Dilapsky/Position_feedback_system_and_method_based_on_FDM_formula_3D_printers/SJTU Final Defense of university students' Innovative Practice Program(English).pdf

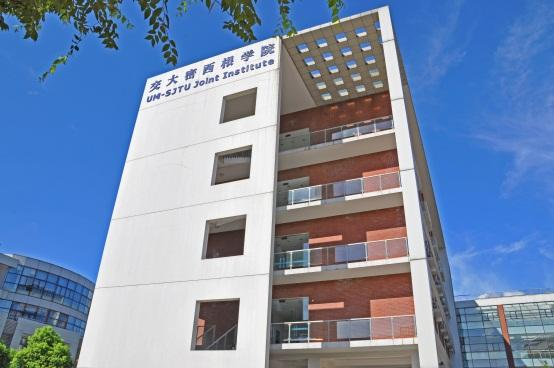
[picture p23: figure]

http://umji.sjtu.edu.cn

Presented by:
李夏涵Li Xiahan
李纯超Li Chunchao

The research about introducing the closed-loop control and blackout continuing printing functions into 3D printers

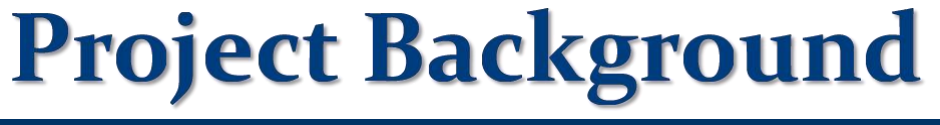
[picture p24: figure]

交大密西根学院 UM-SJTU Joint Institute n Base on the open-loop controlled 3D Printers. n Introduce the closed-loop controlled system

into them by adding the position feedback system whose main part is encoder. n Introduce the blackout continuing printing

system based on previous data. n Thus enhance the accuracy and stability of

3D Printers.

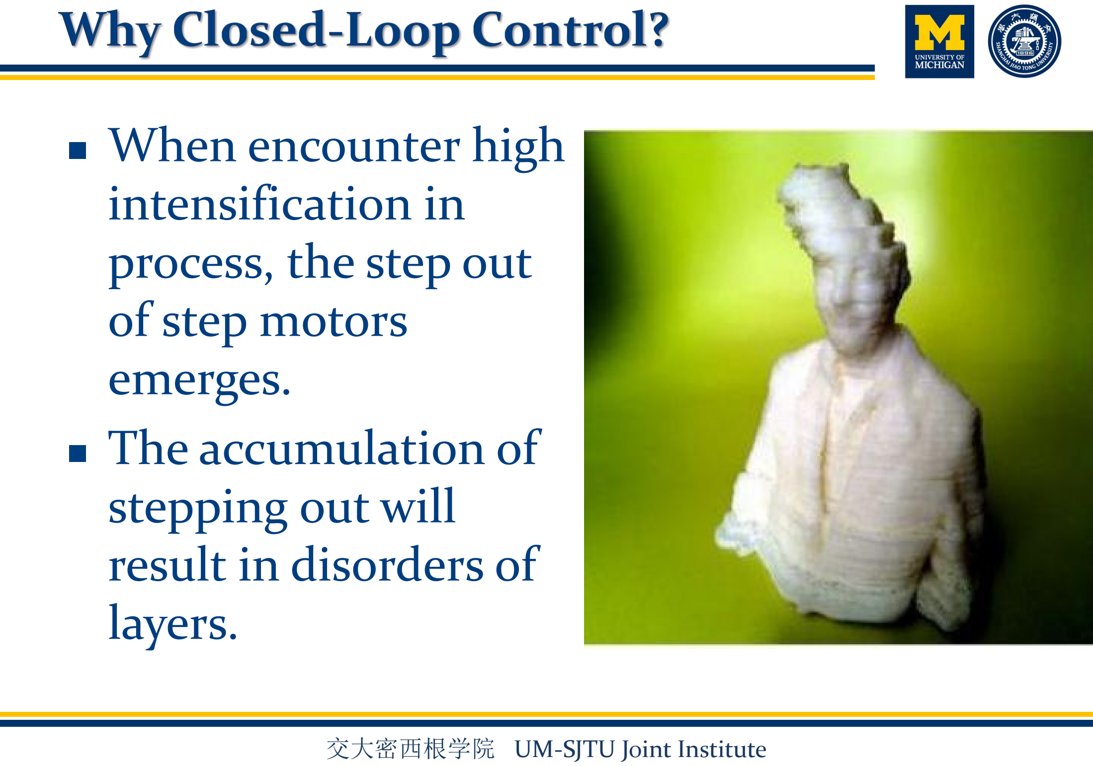
[picture p25: page 3]

n When encounter high
intensification in
process, the step out
of step motors
emerges. n The accumulation of

stepping out will
result in disorders of
layers.

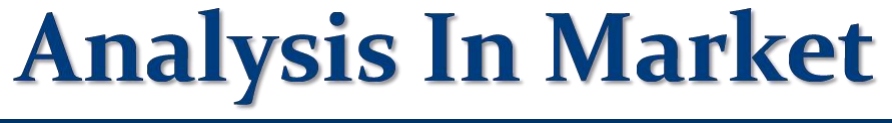
[picture p26: figure]
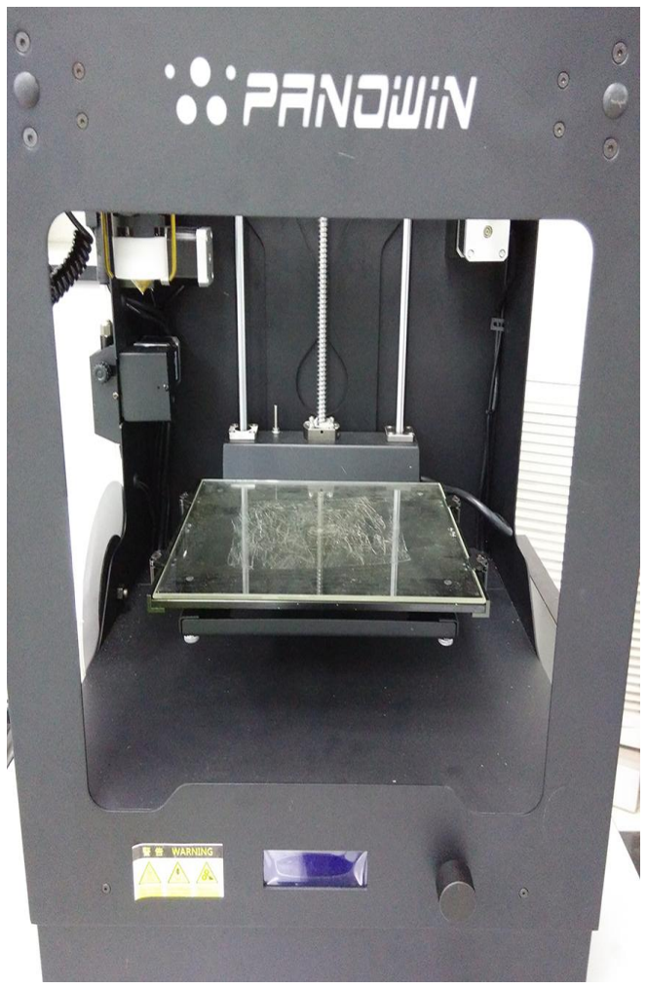
[picture p27: figure]

n Quasi-Industrial 3D prints Closed-Loop Control
Expensive
n Ordinary 3D printers
Open-Loop Control
Affordable
Low-Precision

n 1. Selection of the type of 3D printers n 2. Selection of the type of Encoders n 3. Realization of data transfer
n 4. Realization of close-loop control
n 5. Selection of the module of blackout continuing printing function. n 6. Blackout continuing printing realization

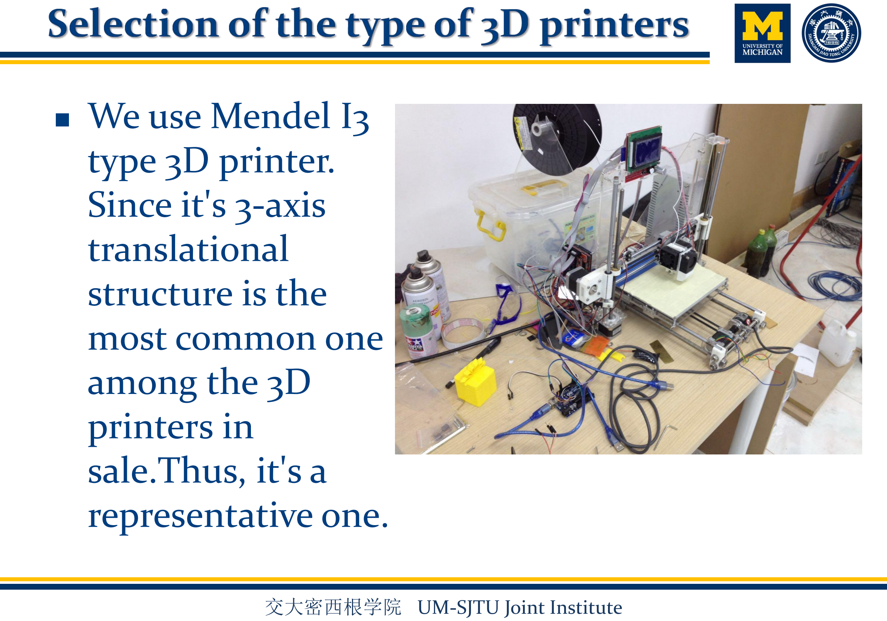
[picture p28: page 6]

n We use Mendel I3
type 3D printer. Since it'
s 3-axis
translational
structure is the
most common one
among the 3D
printers in
sale.Thus, it'

s a
representative one.

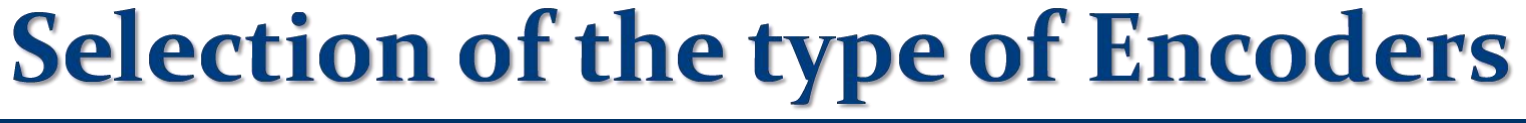
[picture p29: figure]

Price(in RMB) | Additive Type 200 | Absolute Type Above 1000
Advantage | Affordable Easy to Manipulate Low Environment-Affection | Easily Conditioning More Precise
Disadvantage | Difficultly Conditioning Less Precise | Expensive High Environment- Affection

Conclusion: The resolution of x and y axis can reach to 3200, however, the 2000- resolution encoders can recognize the 4000-resolution displacement. Considering about the price and the environment, we will use 2000-resolution encoders

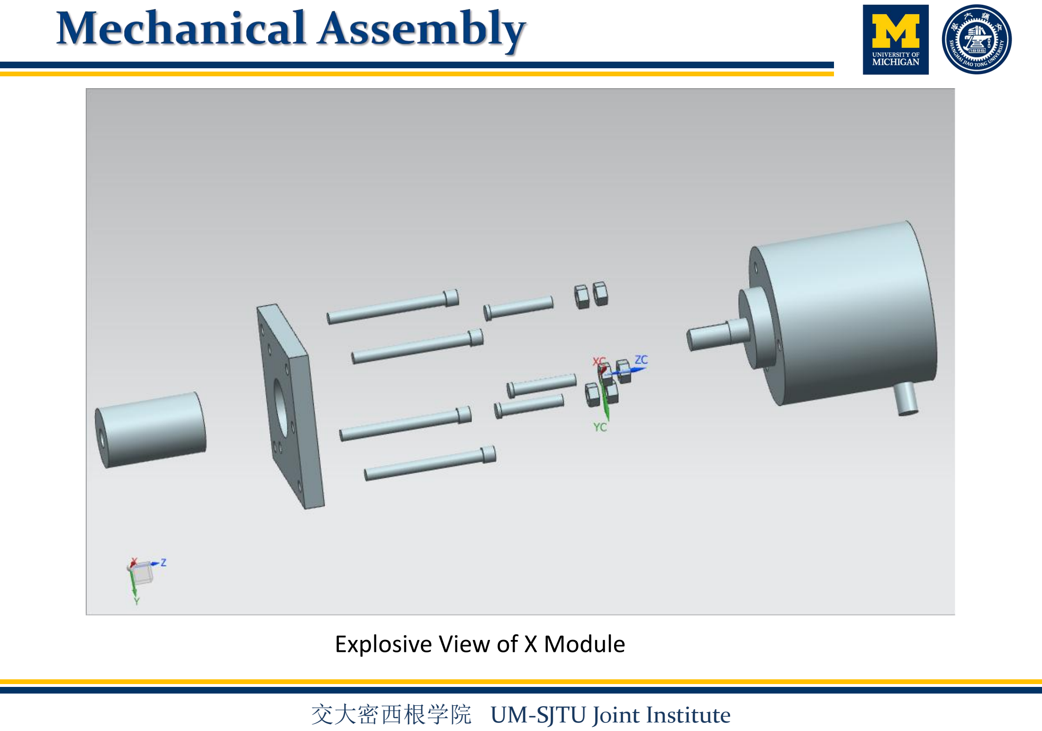
[picture p30: page 8]

Explosive View of X Module

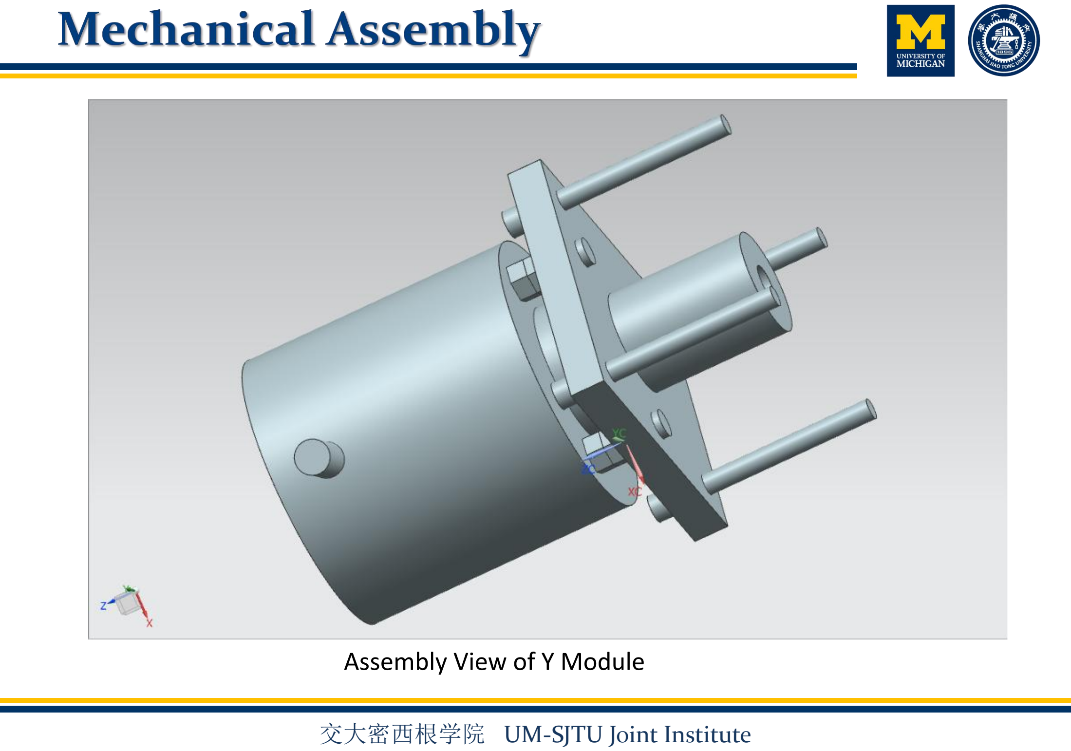
[picture p31: page 9]

Assembly View of Y Module

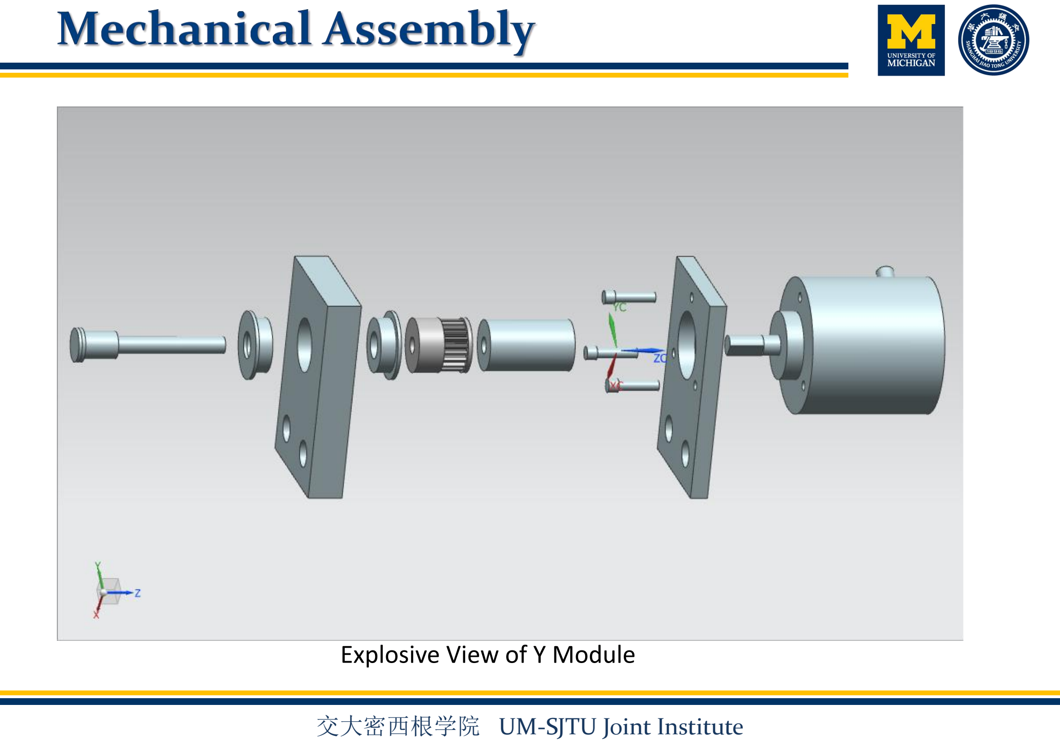
[picture p32: page 10]

Explosive View of Y Module

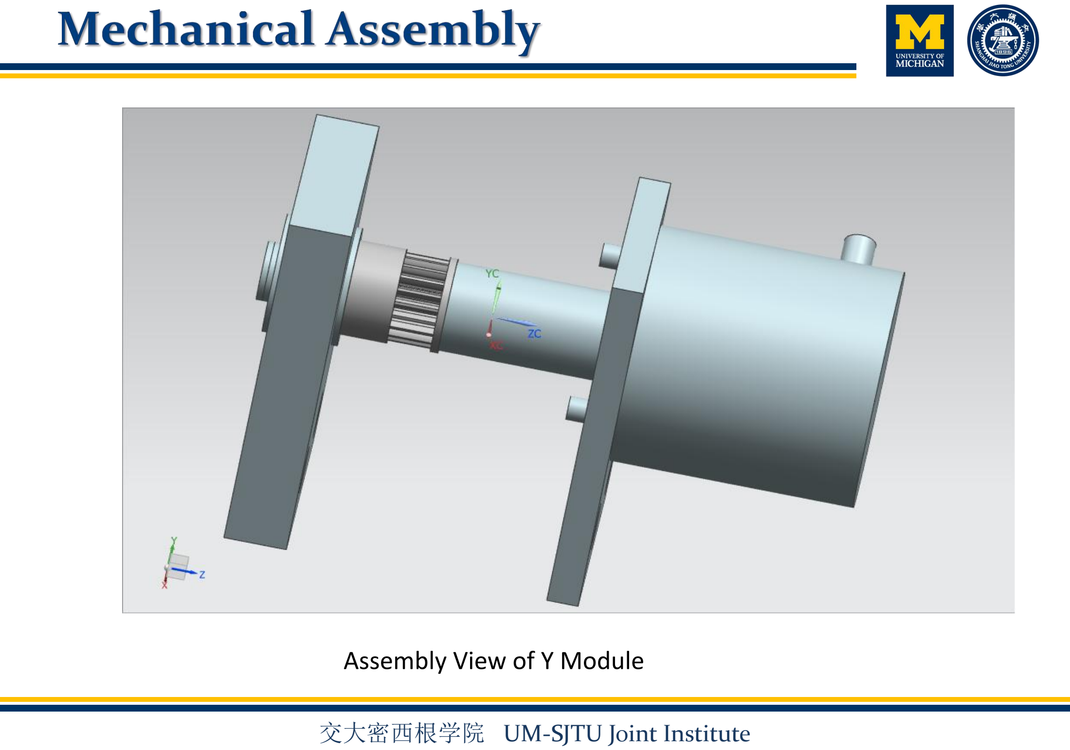
[picture p33: page 11]

Assembly View of Y Module

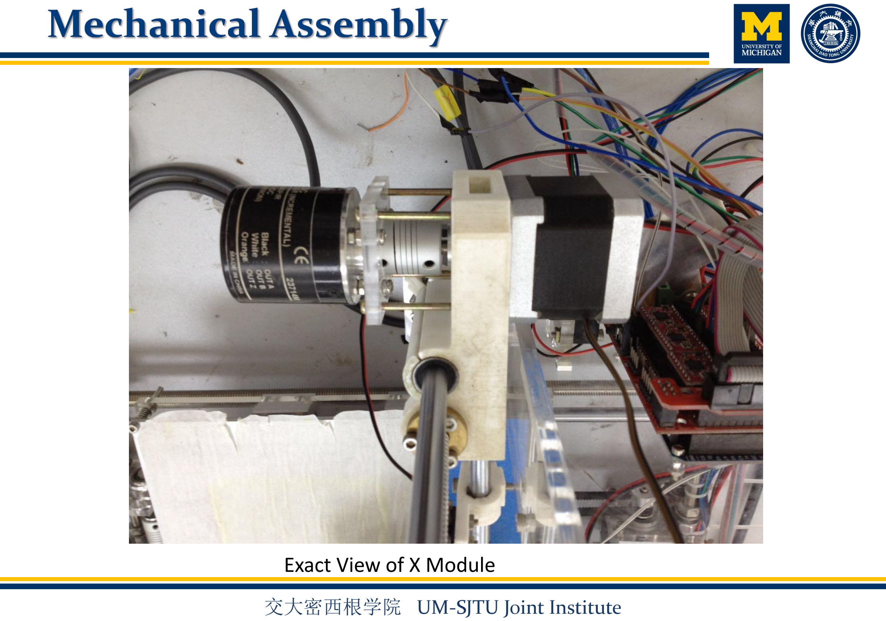
[picture p34: page 12]

Exact View of X Module

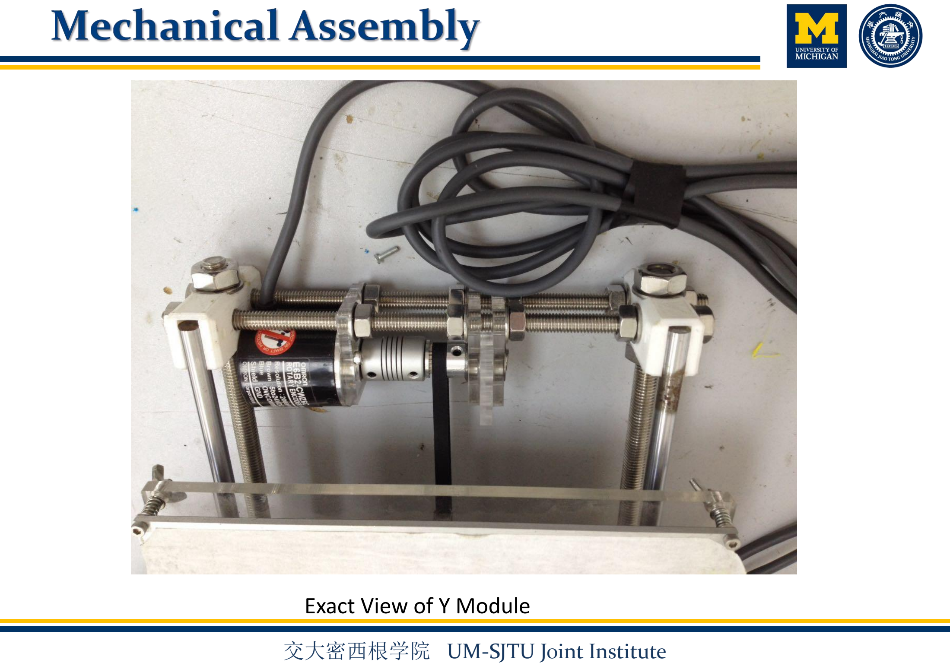
[picture p35: page 13]

Exact View of Y Module

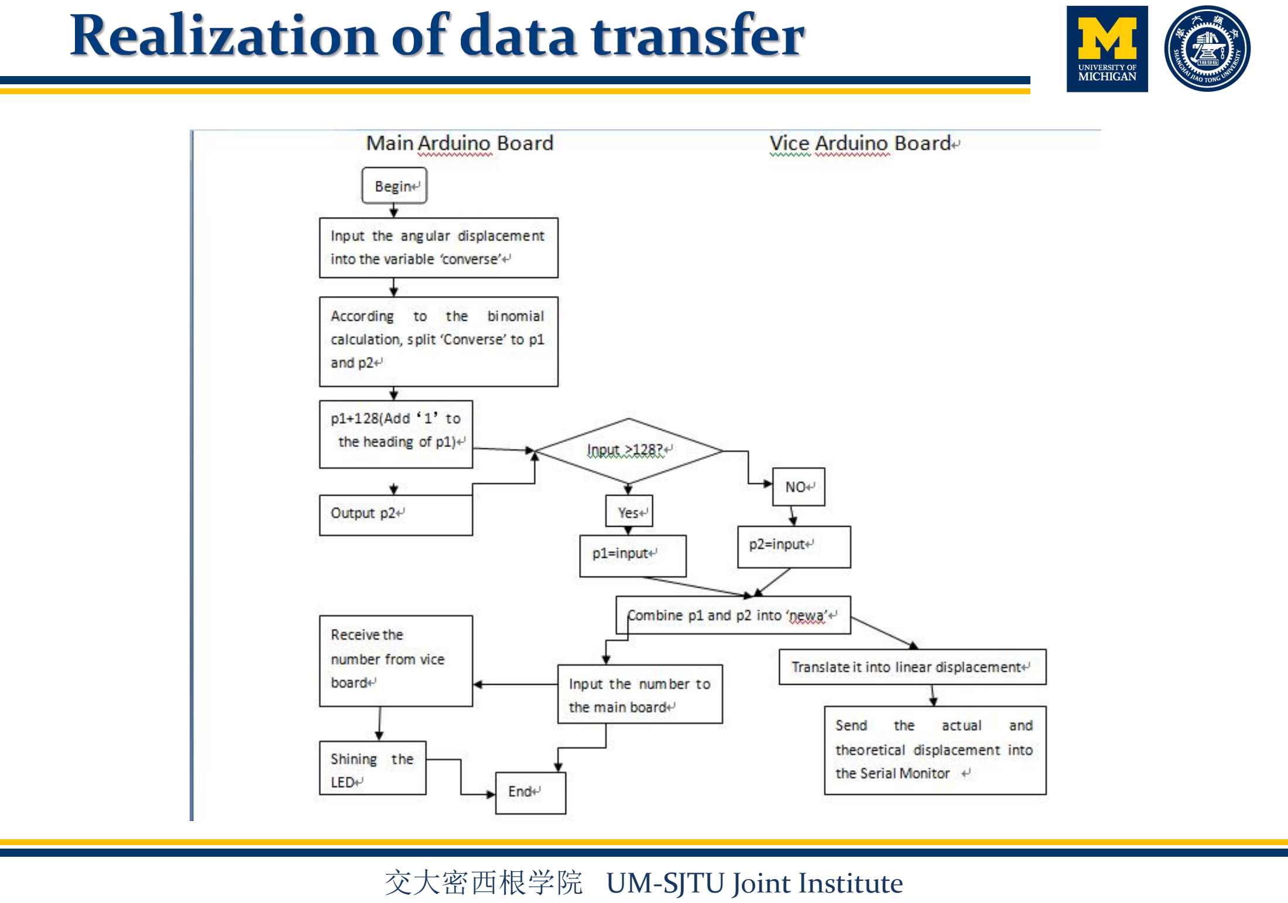
[picture p36: page 14]
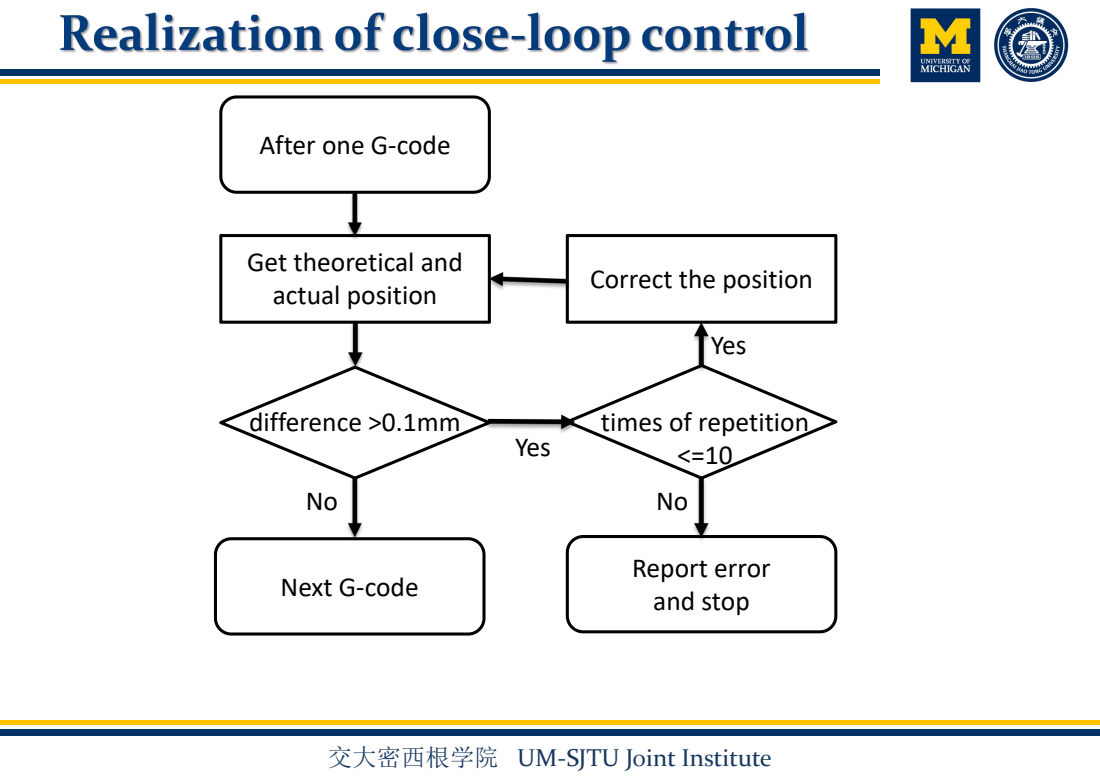
[picture p37: page 15]
difference >0.1mm; times of repetition; Next G-code; Report error and stop; Yes

After one G-code

Get theoretical and
actual position

Correct the position

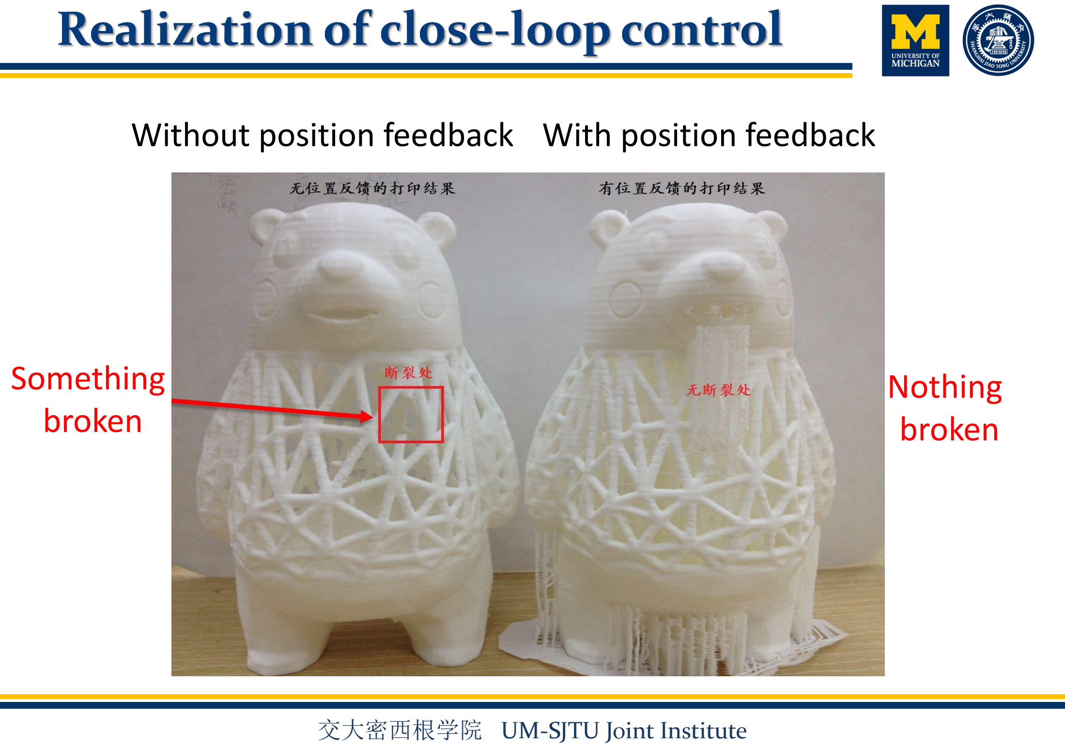
[picture p38: page 16]

Without position feedback With position feedback

Something
broken

Nothing
broken

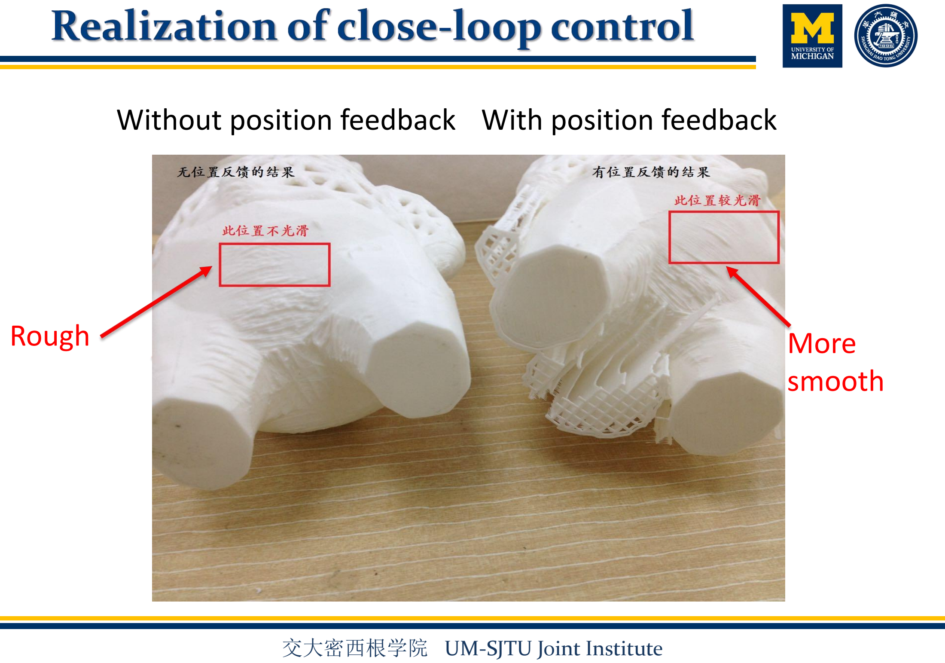
[picture p39: page 17]

Without position feedback With position feedback

Rough | More smooth

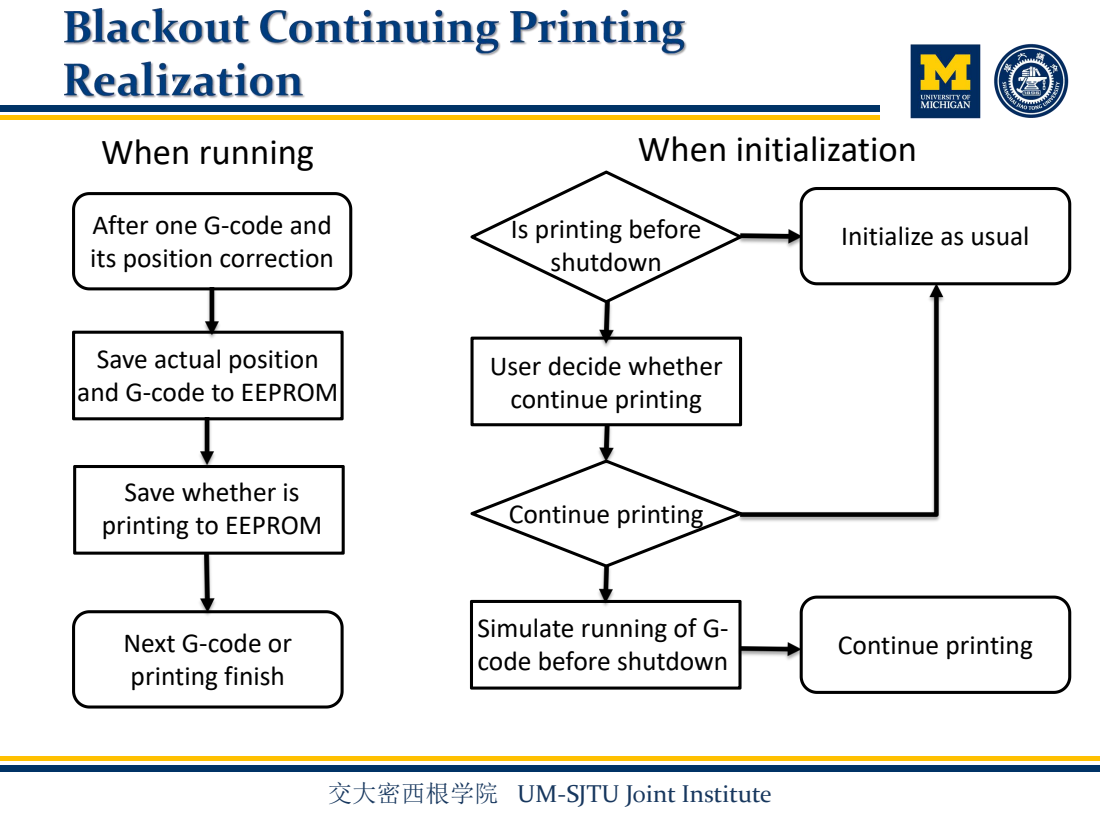
[picture p40: page 18]
When running; When initialization; Continue printing

After one G-code and
its position correction

Is printing before
shutdown

Initialize as usual

Save actual position
and G-code to EEPROM

User decide whether
continue printing

Save whether is
printing to EEPROM

Simulate running of G- code before shutdown

Next G-code or
printing finish

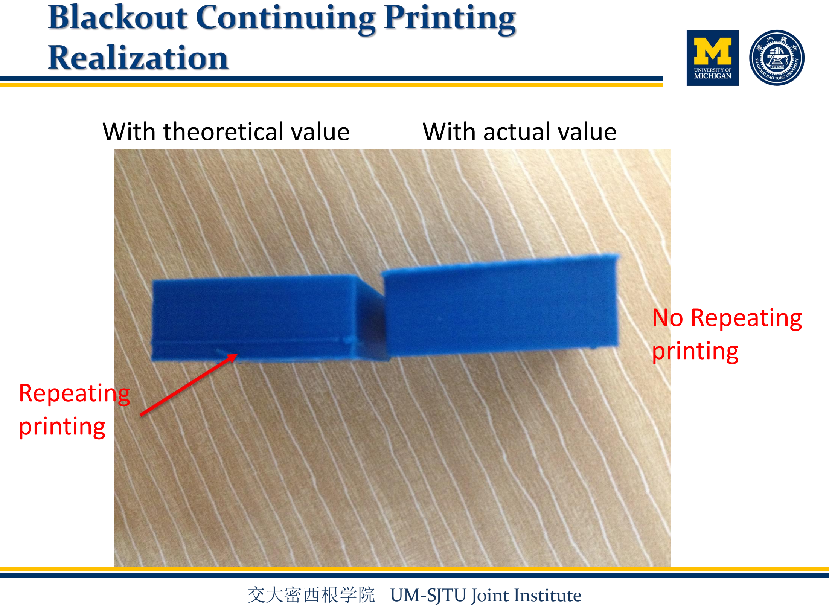
[picture p41: page 19]

With theoretical value With actual value

Repeating
printing

No Repeating
printing

n The data received from encoder is 0-65536. That is, 16 digit in binary system. n However, the Serial Transmission can only

transmit 8 digit in binary system. n So we split the original data into two parts:

former 8 digit and latter 8 digit

n However, how can the receiver distinguish the former digit from latter digit?

In Decimal System

In Binary System

Original Data | Former 8 Digits | Latter 8 Digits

n We add 128 to the former digit as a label, since the latter digit cannot exceed 127.

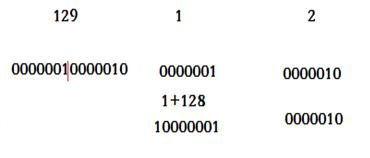
[picture p42: figure]

In Decimal System

In Binary System

Distinction

Original Data | Former 8 Digits | Latter 8 Digits

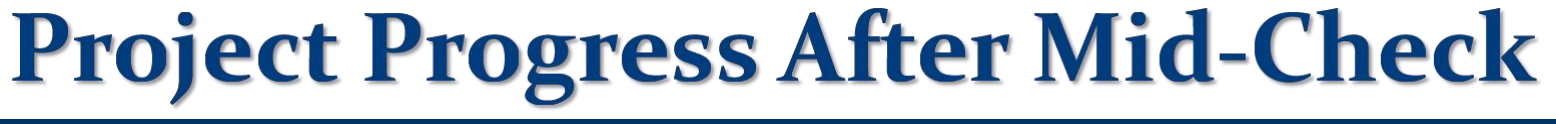
[picture p43: figure]

n Realization of the position of stop point 2017/4/28-2017/5/28
n Realization of blackout continuing printing
functions | 2017/5/28-2017/6/28
n 3D printer testing | 2017/6/28-2017/7/28
n Comparing with other types of 3D printers in
market | 2017/7/28-2017/8/28
n Optimization and conditioning according to the comparing result 2017/8/28-2017/9/28

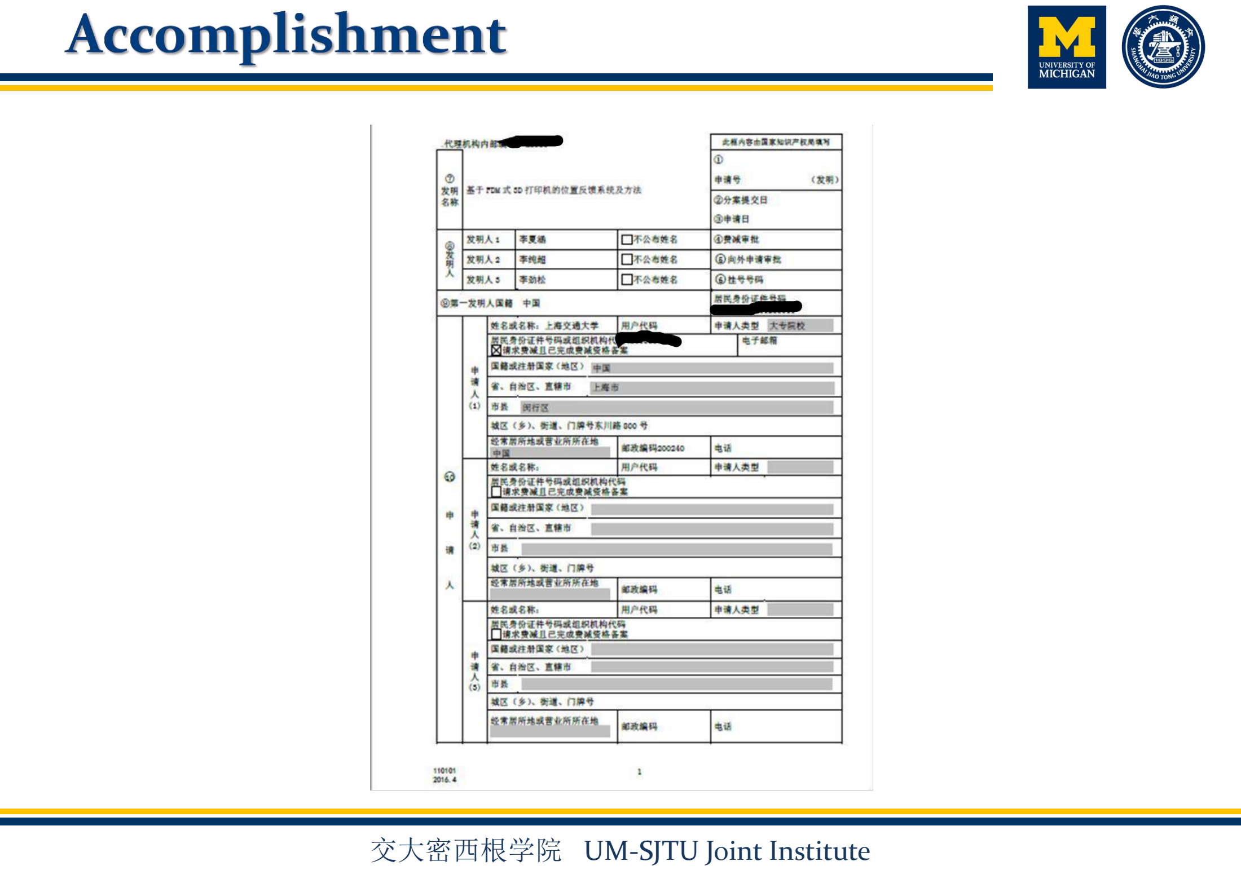
[picture p44: page 24]

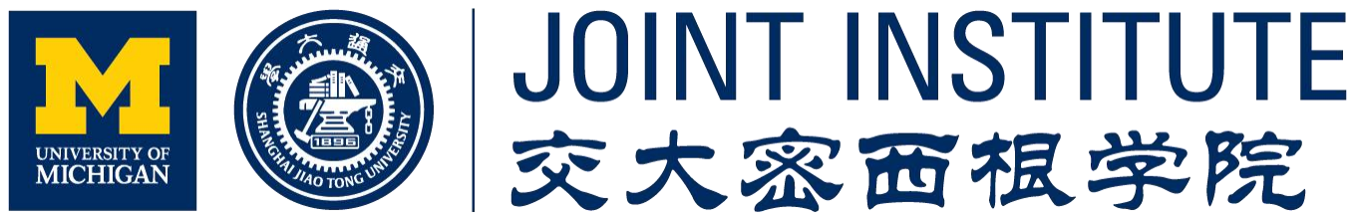
[picture p45: figure]

http://umji.sjtu.edu.cn
