Dilapsky/Position_feedback_system_and_method_based_on_FDM_formula_3D_printers/3D_models_and_Pictures/Real_Photos/Front View 2.jpg

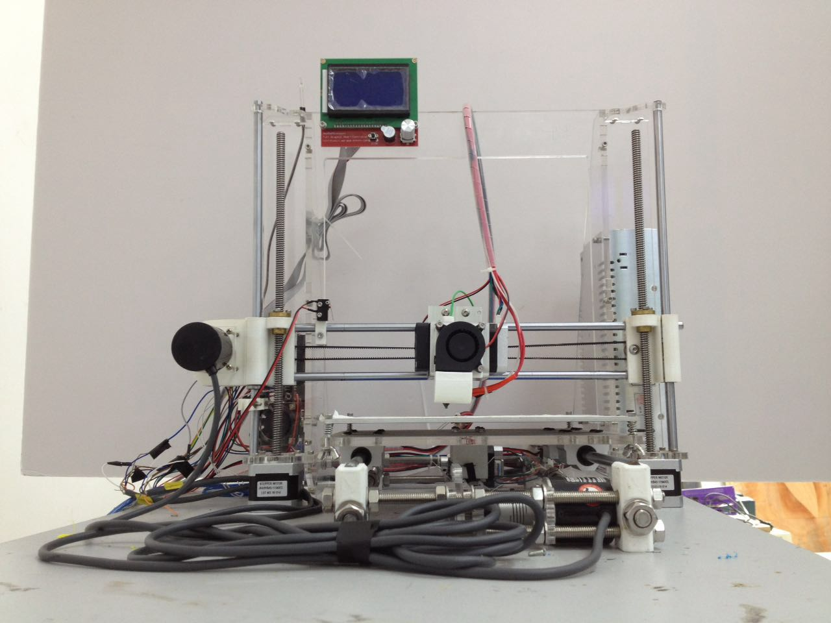
3D_models_and_Pictures/Real_Photos/Front View 2.jpg
