Dilapsky/Position_feedback_system_and_method_based_on_FDM_formula_3D_printers/3D_models_and_Pictures/Real_Photos/Top view 1.jpg

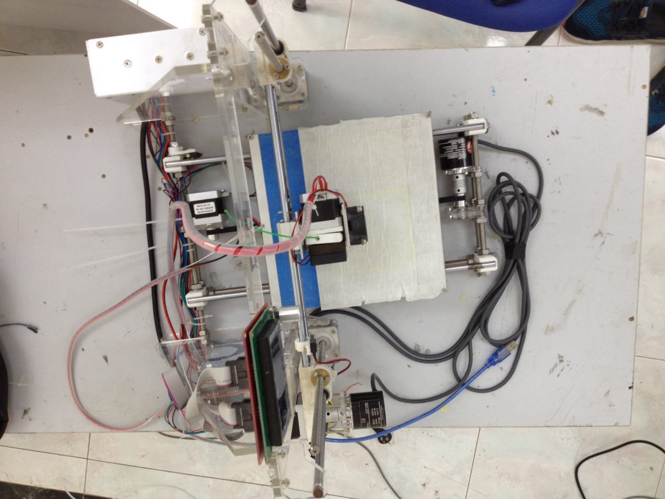
3D_models_and_Pictures/Real_Photos/Top view 1.jpg
