Dilapsky/Position_feedback_system_and_method_based_on_FDM_formula_3D_printers/(list of files, cad)

Other CAD files:
3D_models_and_Pictures/3D_models_by_Siemens-NX/ACRYLIC.prt
3D_models_and_Pictures/3D_models_by_Siemens-NX/BEARING.prt
3D_models_and_Pictures/3D_models_by_Siemens-NX/BIG-ACRYLIC.prt
3D_models_and_Pictures/3D_models_by_Siemens-NX/MODULE.prt
3D_models_and_Pictures/3D_models_by_Siemens-NX/PIVOT.prt
3D_models_and_Pictures/3D_models_by_Siemens-NX/SCREW-LONG.prt
3D_models_and_Pictures/3D_models_by_Siemens-NX/SCREW-SHORT.prt
3D_models_and_Pictures/3D_models_by_Siemens-NX/belt.prt
3D_models_and_Pictures/3D_models_by_Siemens-NX/belt1.prt
3D_models_and_Pictures/3D_models_by_Siemens-NX/coupling.prt
3D_models_and_Pictures/3D_models_by_Siemens-NX/encoder.prt
3D_models_and_Pictures/3D_models_by_Siemens-NX/gear.prt
3D_models_and_Pictures/3D_models_by_Siemens-NX/motor.prt
3D_models_and_Pictures/3D_models_by_Siemens-NX/motoryacrylic.prt
3D_models_and_Pictures/3D_models_by_Siemens-NX/nut.prt
3D_models_and_Pictures/3D_models_by_Siemens-NX/rodylong.prt
3D_models_and_Pictures/3D_models_by_Siemens-NX/rodyshort.prt
3D_models_and_Pictures/3D_models_by_Siemens-NX/x-acrylic.prt
3D_models_and_Pictures/3D_models_by_Siemens-NX/x-module.prt
3D_models_and_Pictures/3D_models_by_Siemens-NX/x-screw.prt
3D_models_and_Pictures/3D_models_by_Siemens-NX/yassembly.prt
3D_models_and_Pictures/3D_models_by_Siemens-NX/yconnection.prt
3D_models_and_Pictures/3D_models_by_Siemens-NX/yconnection1.prt
3D_models_and_Pictures/3D_models_by_Siemens-NX/yframe.prt
