Dilapsky/Position_feedback_system_and_method_based_on_FDM_formula_3D_printers/3D_models_and_Pictures/Assembly_Drawing/Y axis frame.png

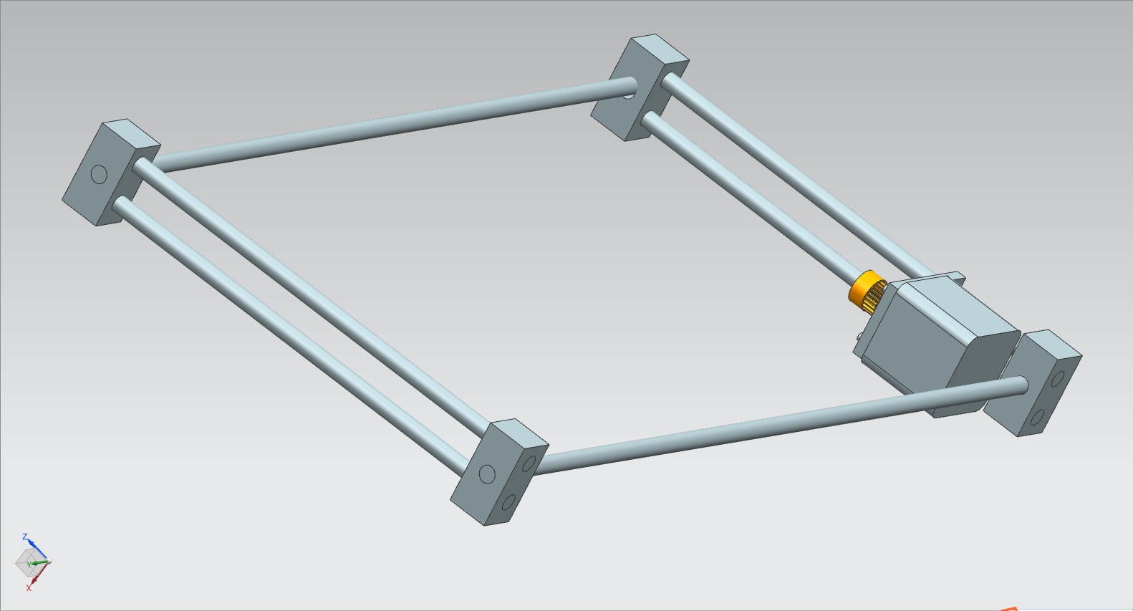
3D_models_and_Pictures/Assembly_Drawing/Y axis frame.png
